duanebenson-SC/SC_UnoNeoClockV1.2/README.md

# SC_UnoNeoClockV1.2
Screaming Circuits clock board, fully compatible with Arduino UNO. Has 12 NeoPixels as hour indicators, and RTC with battery backup

Still to come: Bill of materials and instructions for assmebling the clock.
