duanebenson-SC/SC_UnoNeoClockV1.2/Battery pack for SC_UnoNeoClock.stl

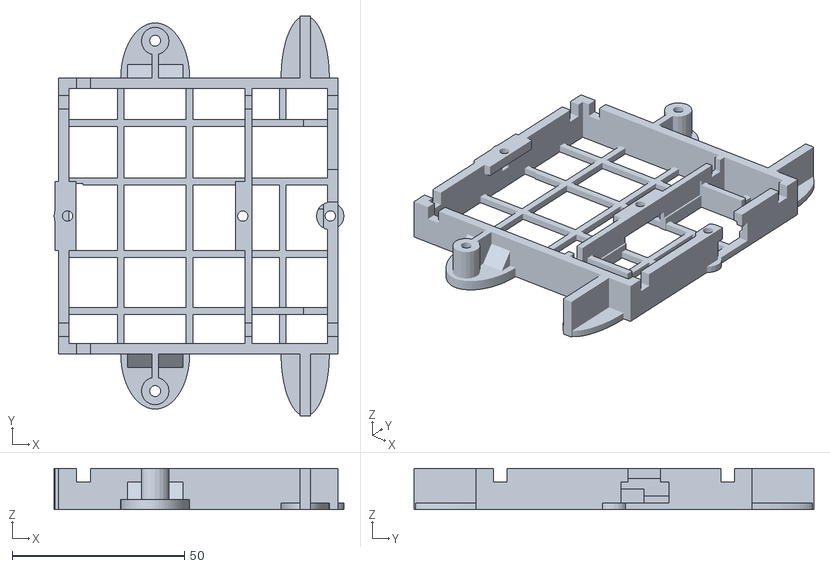
[picture p1: CAD file, 2018-05-17]
Battery pack for SC_UnoNeoClock.stl
84.1 x 116.0 x 12.0
