duanebenson-SC/SC_UnoNeoClockV1.2/Basic Clock closed frame fo SC_UnoNeoClock.stl

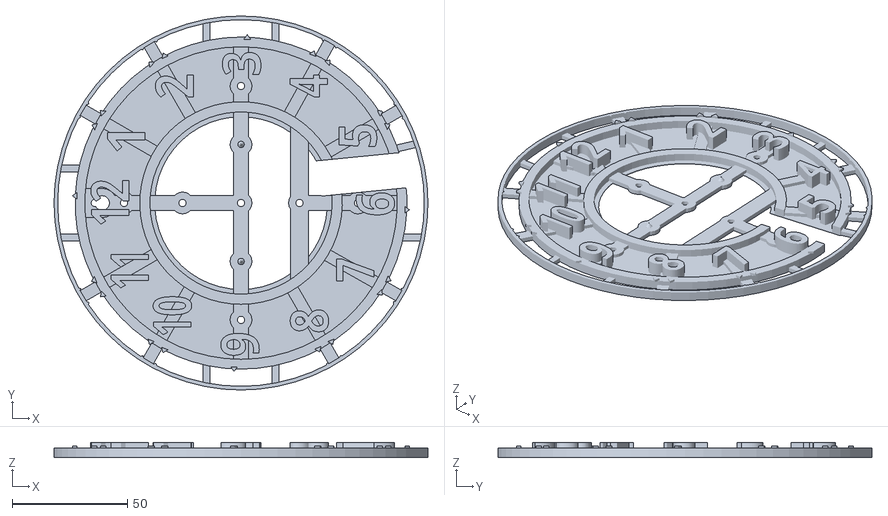
[picture p2: CAD file, 2018-05-17]
Basic Clock closed frame fo SC_UnoNeoClock.stl
162.5 x 162.5 x 6.35
