duanebenson-SC/SC_UnoNeoClockV1.2/Clock desk stand.stl

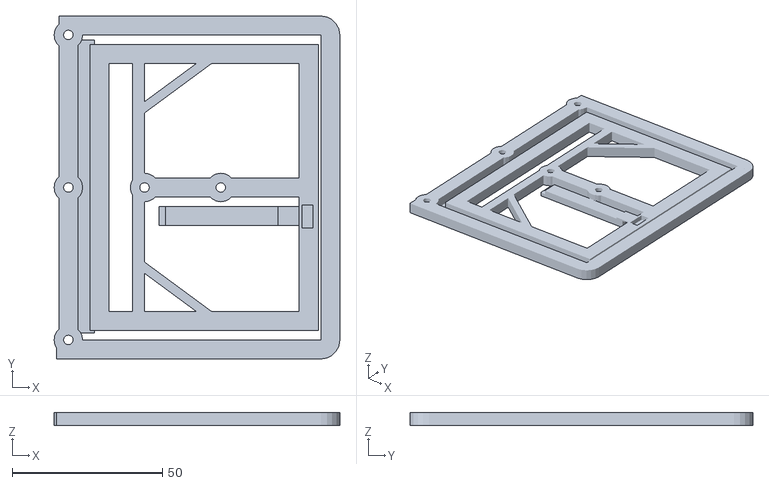
[picture p3: CAD file, 2018-05-17]
Clock desk stand.stl
95.3 x 114.3 x 4.45
